RoboSAX/eagle_licht/soldering/connectors.jpg

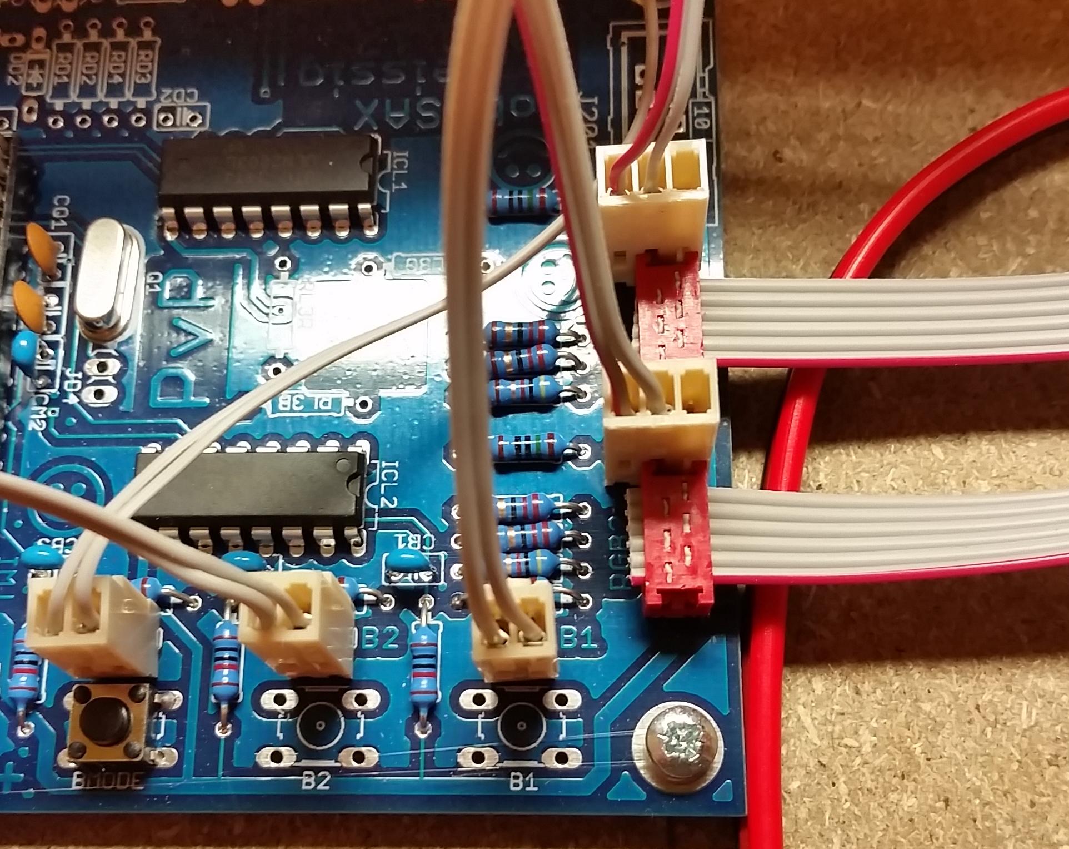
soldering/connectors.jpg
