RoboSAX/eagle_licht/soldering/rgb_led/rgb_led.jpg

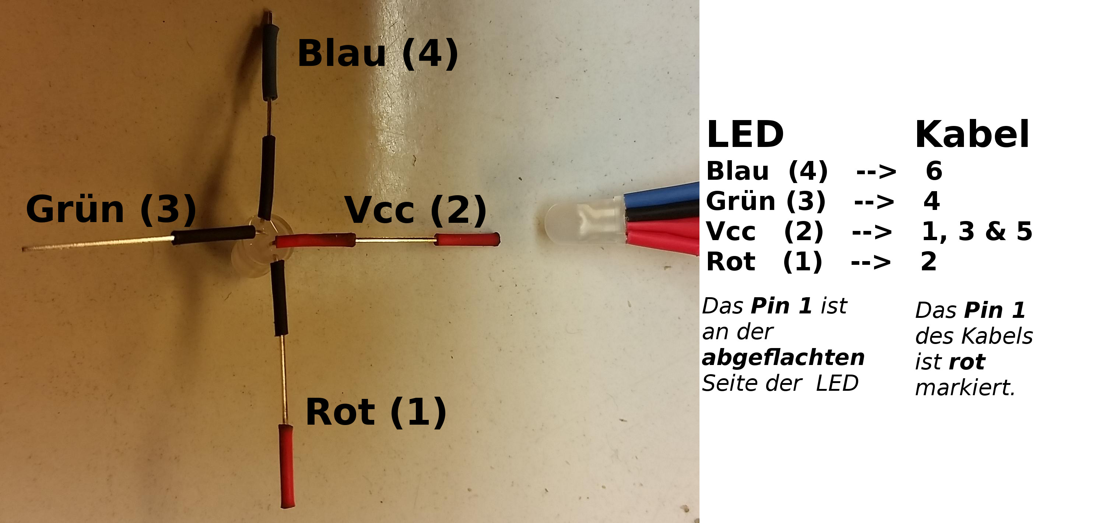
soldering/rgb_led/rgb_led.jpg
