RoboSAX/eagle_licht/README.md

# eagle_licht
Vereinfachte Platine für das Spielfeld des RoboSAX ab 2018
