RoboSAX/eagle_licht/export/images/simplified/circuit_simplified.png

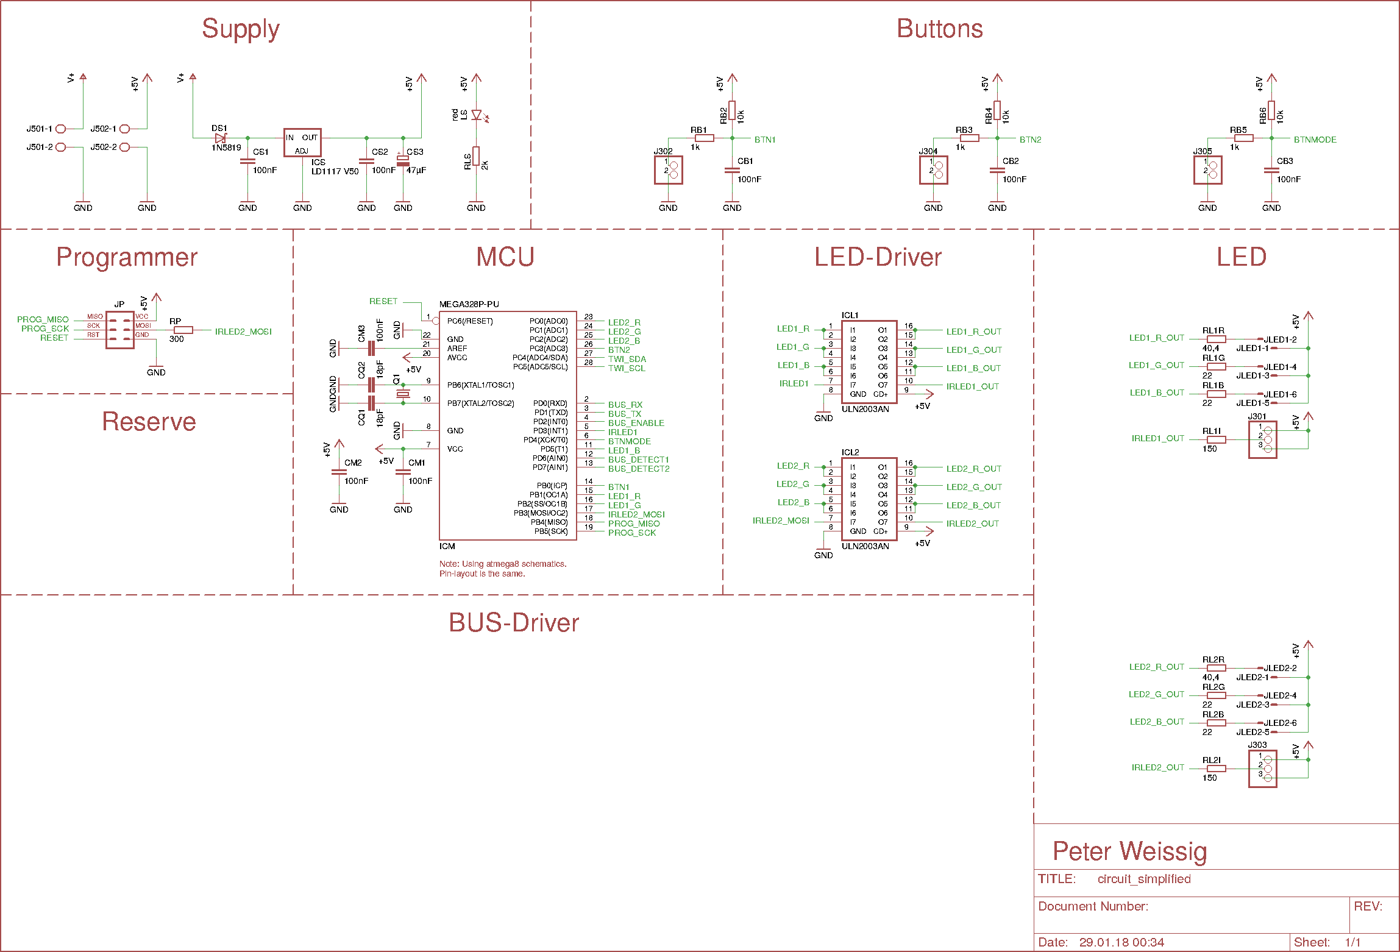
export/images/simplified/circuit_simplified.png
