RoboSAX/eagle_licht/parts/full/parts.pdf

## RoboSAX light tht

Peter Weissig | Seite 1 von 2 | 11.02.2018
Name | Value / Description | Order code | # | Prize | Sum
B1, B2, BMODE | button; 6x6mm; h=5mm | | 3 | 0,13 € | 0,39 €
CQ1, CQ2 | 18pF; 2,5mm | | 2 | 0,06 € | 0,12 €
CD1, CD2 | 100pF; 2,5mm | | 2 | 0,06 € | 0,12 €
| 100nF; 2,5mm | | 9 | 0,05 € | 0,45 €
CS3 | 47µF; 2mm; d=5mm | | 1 | 0,03 € | 0,03 €
DD1, DD2 | fast, low cap | | 2 | 0,02 € | 0,04 €
DS | low drop | | 1 | 0,06 € | 0,06 €
ICD | driver rs485 | | 1 | 0,34 € | 0,34 €
| | | 1 | 1,99 € | -
ICL1, ICL2 | transistor array | | 2 | 0,32 € | 0,64 €
ICM | atmega 328P | | 1 | 2,50 € | 2,50 €
ICS | low-drop; 5V; 1A | | 1 | 0,51 € | 0,51 €
JD1, JD2, JD3, JD4 | jumper; 1x2 pins | | 0,25 | 0,17 € | 0,04 €
| | | 4 | 0,04 € | -
J302, J304, J305 | special pin head; 1x2 pins (https://www.reichelt.de/Platinen-Steckverbinder/PSS-254-2G/3/index.html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) | 3 | 0,03 € | 0,09 €
J301, J303 | special pin head; 1x3 pins (https://www.reichelt.de/Platinen-Steckverbinder/PSS-254-3G/3/index.html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) | 2 | 0,03 € | 0,06 €
JP6 | special pin head; 90°; 1x6 | 1 | 0,14 € | 0,14 €
JT | female header; 1x4 pins | | 1 | 0,16 € | 0,16 €
| | | 0,25 | 0,27 € | -
JP | box header; 2x3 pins | | 1 | 0,16 € | 0,16 €
J201, J202 | box header; 2x5 pins | | 2 | 0,09 € | 0,18 €
JLED1, JLED2 | micromatch; 2x3 pins | | 2 | 0,31 € | 0,62 €
J501, J502 | connecting teminal; 2x | | 2 | 0,31 € | 0,62 €
LD2 | 3mm; 2mA; green | | 1 | 0,13 € | 0,13 €
LD1, LS | 3mm; 2mA, red | | 2 | 0,09 € | 0,18 €
LED3 | RGB-led; smd | | 1 | 0,40 € | 0,40 €
Q1 | crystal; 16 MHz | | 1 | 0,22 € | 0,22 €
RD3 | ? | ? | 1 | 0,05 € | 0,05 €
RD4 | ? | ? | 1 | 0,05 € | 0,05 €
| 22 | | 6 | 0,05 € | 0,30 €
RL1R, RL2R, RL3R | 40,4 | | 3 | 0,05 € | 0,15 €
| 150 | | 4 | 0,05 € | 0,20 €
RP | 300 | | 1 | 0,05 € | 0,05 €
| 1k | | 5 | 0,05 € | 0,25 €
RLD1, RLD2, RLS | 2k | | 3 | 0,05 € | 0,15 €
| 10k | | 5 | 0,05 € | 0,25 €
RD2 | 100k | | 1 | 0,05 € | 0,05 €

9,71 €

Shopping cart (most parts):

TASTER 9302 (https://www.reichelt.de/Kurzhubtaster/TASTER-9302/3/index.html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)
KERKO 18P (https://www.reichelt.de/Kurzhubtaster/TASTER-9302/3/index.html?ACTION=3;ARTICLE=9274)
KERKO 100P (https://www.reichelt.de/Kurzhubtaster/TASTER-9302/3/index.html?ACTION=3;ARTICLE=9266)
CB1, CB2, CB3
CM1, CM2, CM3,
CD3, CS1, CS2

X7R-2,5 100N (https://www.reichelt.de/Kurzhubtaster/TASTER-9302/3/index.html?ACTION=3;ARTICLE=22853)

RAD 105 47/35 (https://www.reichelt.de/Kurzhubtaster/TASTER-9302/3/index.html?ACTION=3;ARTICLE=42399)
1N 4151 DIO (https://www.reichelt.de/1N-UF-AA-Dioden/1N-4151-DIO/3/index.html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)
1N 5819 (https://www.reichelt.de/1N-UF-AA-Dioden/1N-4151-DIO/3/index.html?ACTION=3;ARTICLE=41850)
SN 75176BP (https://www.reichelt.de/1N-UF-AA-Dioden/1N-4151-DIO/3/index.html?ACTION=3;ARTICLE=19202)
ADM 485 JN (https://www.reichelt.de/1N-UF-AA-Dioden/1N-4151-DIO/3/index.html?ACTION=3;ARTICLE=107974)
ULN 2003A (https://www.reichelt.de/1N-UF-AA-Dioden/1N-4151-DIO/3/index.html?ACTION=3;ARTICLE=22069)
ATMEGA 328P-PU (https://www.reichelt.de/1N-UF-AA-Dioden/1N-4151-DIO/3/index.html?ACTION=3;ARTICLE=119685)
LD1117 V50 (https://www.reichelt.de/1N-UF-AA-Dioden/1N-4151-DIO/3/index.html?ACTION=3;ARTICLE=200893)
SL 1X36G 2,54 (https://www.reichelt.de/Stiftleisten/SL-1X36G-2-54/3/index.html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)
RND 205-00623 (https://www.reichelt.de/Stiftleisten/RND-205-00623/3/index.html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)
PSS 254/2G (https://www.reichelt.de/Platinen-Steckverbinder/PSS-254-2G/3/index.html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)
PSS 254/3G (https://www.reichelt.de/Platinen-Steckverbinder/PSS-254-3G/3/index.html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)
PSS 254/6W (https://www.reichelt.de/Platinen-Steckverbinder/PSS-254-2G/3/index.html?ACTION=3;ARTICLE=217631)
MPE 094-1-004 (https://www.reichelt.de/Buchsenleisten/MPE-094-1-004/3/index.html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)
BL 1X20G8 2,54 (https://www.reichelt.de/Buchsenleisten/MPE-094-1-004/3/index.html?ACTION=3;ARTICLE=51827)
WSL 6G (https://www.reichelt.de/Stiftleisten/RND-205-00623/3/index.html?ACTION=3;ARTICLE=85732)
WSL 10G (https://www.reichelt.de/Stiftleisten/RND-205-00623/3/index.html?ACTION=3;ARTICLE=22816)
MPE 369-1-006 (https://www.reichelt.de/Buchsenleisten/MPE-094-1-005/3/index.html?ACTION=3;ARTICLE=120008)
AKL 101-02 (https://www.reichelt.de/Buchsenleisten/MPE-094-1-005/3/index.html?ACTION=3;ARTICLE=36605)
LED 3MM 2MA GN (https://www.reichelt.de/Platinen-Steckverbinder/PSK-254-2W/3/index.html?ACTION=3;ARTICLE=21624)
LED 3MM 2MA RT (https://www.reichelt.de/Platinen-Steckverbinder/PSK-254-2W/3/index.html?ACTION=3;ARTICLE=21626)
LRTBG6TG (other) (https://www.ebay.de/itm/LRTBG6TG-RGB-PLCC6-6-LEAD-MULTILED-rot-grun-blau-LED-OSRAM-100-Stuck-/191014679655)
16,0000-HC49U-S (https://www.reichelt.de/Platinen-Steckverbinder/PSK-254-2W/3/index.html?ACTION=3;ARTICLE=32852)

RL1B, RL1G, RL2B,
RL2G, RL3B, RL3G

METALL 22,0 (https://www.reichelt.de/Platinen-Steckverbinder/PSK-254-2W/3/index.html?ACTION=3;ARTICLE=11621)

METALL 40,2 (https://www.reichelt.de/Platinen-Steckverbinder/PSK-254-2W/3/index.html?ACTION=3;ARTICLE=11790)
RL1I, RL2I, RD1,
RD6

METALL 150 (https://www.reichelt.de/Platinen-Steckverbinder/PSK-254-2W/3/index.html?ACTION=3;ARTICLE=11527)

METALL 300 (https://www.reichelt.de/Platinen-Steckverbinder/PSK-254-2W/3/index.html?ACTION=3;ARTICLE=11715)
RB1, RB3, RB5,
RD5, RD7

METALL 1,00K (https://www.reichelt.de/Platinen-Steckverbinder/PSK-254-2W/3/index.html?ACTION=3;ARTICLE=11403)

METALL 2,00K (https://www.reichelt.de/Platinen-Steckverbinder/PSK-254-2W/3/index.html?ACTION=3;ARTICLE=11578)
RB2, RB4, RB6,
RD8, RD9

METALL 10,0K (https://www.reichelt.de/Platinen-Steckverbinder/PSK-254-2W/3/index.html?ACTION=3;ARTICLE=11449)

METALL 100K (https://www.reichelt.de/Platinen-Steckverbinder/PSK-254-2W/3/index.html?ACTION=3;ARTICLE=11458)

https://www.reichelt.de/my/1433464

## Additionals

Peter Weissig | Seite 2 von 2 | 11.02.2018
Related Part | Value / Description | Order code | # | Prize | Sum
ICD | ic socket; 2x4 | 1 | 0,04 € | 0,04 €
ICL1, ICL2 | ic socket; 2x8 | 2 | 0,05 € | 0,10 €
ICM | ic socket; 2x14 | 1 | 0,10 € | 0,10 €
J302, J304, J305 | special socket; 1x2 pins | 3 | 0,01 € | 0,03 €
J301, J303 | special socket; 1x3 pins | 2 | 0,01 € | 0,02 €
JP6 | special socket; 1x6 pins | 1 | 0,07 € | 0,07 €
pins for special connector | 0,29 € | 0,29 €
JLED1, JLED2 | micromatch; 2x3 pins | 2 | 0,24 € | 0,48 €
J201, J202 | connector for box header | 2 | 0,09 € | 0,18 €
J501 | wire; 2x0,75mm²; power | | | 10,30 € | 0,21 €
| wire; 10x0,1mm²; data | | | 8,60 € | 0,29 €
| shrink tubing; d=1,6mm; b (https://www.reichelt.de/Schrumpfschlauch-Abschnitte/SDH-1-6-SW/3/index.html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) | | 0,25 € | 0,03 €
| shrink tubing; d=1,6mm; r | | 0,32 € | 0,03 €
JLED1, JLED2, JT | shrink tubing; d=1,6mm; b (https://www.reichelt.de/Schrumpfschlauch-Abschnitte/SDH-1-6-SW/3/index.html?ACTION=3;ARTICLE=17392) | | 0,32 € | 0,03 €
J302, J304, J305 | shrink tubing; d=3,2mm; b (https://www.reichelt.de/?ACTION=3;ARTICLE=17406) | | 0,26 € | 0,03 €
JLED1, JLED2 | shrink tubing; d=3,2mm; r | | 0,31 € | 0,03 €
J501 | shrink tubing; d=6,4mm; r | | 0,50 € | 0,05 €
J501 | switch; power supply | 1 | 0,81 € | 0,81 €
B1, B2, BMODE | button; signal | 3 | 0,47 € | 1,41 €
J501 | battery; 9V | 1 | 0,99 € | 0,99 €
J501 | battery clip | 1 | 0,67 € | 0,67 €
J301, J303 | IR led; 5mm | 2 | 0,26 € | 0,52 €
JLED1, JLED2 | RGB led; 5-8mm | | 7,99 € | 0,16 €
ICS | screw; m3; 8mm | | 1,99 € | 0,01 €
ICS | nut; m3 | | 2,50 € | 0,03 €
| washer; m3 | | 1,85 € | 0,11 €
| screw; 2,9mm | | 1,75 € | 0,11 €

6,77 €

Shopping cart (most parts):

GS 8 (https://www.reichelt.de/?ACTION=3;ARTICLE=8230)
GS 16 (https://www.reichelt.de/?ACTION=3;ARTICLE=8208)
GS 28-S (https://www.reichelt.de/?ACTION=3;ARTICLE=86281)
PSK 254/2W (https://www.reichelt.de/Platinen-Steckverbinder/PSK-KONTAKTE/3/index.html?ACTION=3;ARTICLE=14857)
PSK 254/3W (https://www.reichelt.de/Platinen-Steckverbinder/PSK-254-3W/3/index.html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)
PSK 254/6W (https://www.reichelt.de/Platinen-Steckverbinder/PSK-KONTAKTE/3/index.html?ACTION=3;ARTICLE=147625)
J301, J302, J303, J304,
J305, JP6
PSK-KONTAKTE (https://www.reichelt.de/Platinen-Steckverbinder/PSK-KONTAKTE/3/index.html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) | 18 (20)

MPE 372-1-006 (https://www.reichelt.de/Platinen-Steckverbinder/PSK-254-3W/3/index.html?ACTION=3;ARTICLE=120050)
PFL 10 (https://www.reichelt.de/Pfosten-Wannenstecker/2/index.html?ACTION=3;ARTICLE=14571)
LA 275-50 (https://www.reichelt.de/Pfosten-Wannenstecker/2/index.html?ACTION=3;ARTICLE=36246) | 1 (50)

J201, J202,
JLED1, JLED2, JT,
J301, J303,
J302, J304, J305

AWG 28-10G 30M (https://www.reichelt.de/Flachbandkabel/AWG-28-10G-30M/3/index.html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) 1 (30)

JLED1, JLED2,
J301, J303
SDH 1,6 SW (https://www.reichelt.de/Schrumpfschlauch-Abschnitte/SDH-1-6-SW/3/index.html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) | 1 (10)

JLED1, JLED2,
J301, J303
SDH 1,6 RT (https://www.reichelt.de/Schrumpfschlauch-Abschnitte/SDH-1-6-SW/3/index.html?ACTION=3;ARTICLE=17393) | 1 (10)
SDH 1,6 BL (https://www.reichelt.de/Schrumpfschlauch-Abschnitte/SDH-1-6-SW/3/index.html?ACTION=3;ARTICLE=17392) | 1 (10)
SDH 3,2 SW (https://www.reichelt.de/?ACTION=3;ARTICLE=17406) | 1 (10)
SDH 3,2 RT (https://www.reichelt.de/?ACTION=3;ARTICLE=17405) | 1 (10)
SDH 6,4 RT (https://www.reichelt.de/?ACTION=3;ARTICLE=17413) | 1 (10)

WS R13-112 AAAA (https://www.reichelt.de/Wippschalter/WS-R13-112-AAAA/3/index.html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)
T 113A RT (https://www.reichelt.de/Drucktaster-Druckschalter/T-113A-RT/3/index.html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)
VAR IND1 9V (https://www.reichelt.de/Alkalinebatterien/VAR-IND1-9V/3/index.html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)
HALTER 9V (https://www.reichelt.de/Batteriehalter-fuer-9V-Block/HALTER-9V/3/index.html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)
CQY 99 (https://www.reichelt.de/Fotodioden-etc-/CQY-99/3/index.html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)
Amazon (https://www.amazon.de/St%C3%BCck-Ultra-Helle-Indirekt-Common/dp/B00H96MFNI/ref=sr_1_1) | 2 (100)
SZK M3X8-200 (https://www.reichelt.de/Flachbandkabel/AWG-28-10G-30M/3/index.html?ACTION=3;ARTICLE=65693) | 1 (200)
SK-E M3-100 (https://www.reichelt.de/Flachbandkabel/AWG-28-10G-30M/3/index.html?ACTION=3;ARTICLE=72592) | 1 (100)

ICS,
corners of circuit board
SKU-E 3,2-100 (https://www.reichelt.de/Flachbandkabel/AWG-28-10G-30M/3/index.html?ACTION=3;ARTICLE=72588) | 6 (100)

corners of circuit board,
battery clip
SBL 2916-100 (https://www.reichelt.de/Blechschrauben/SBL-2913-100/3/index.html?ACTION=3;ARTICLE=130327) | 6 (100)

https://www.reichelt.de/my/1433464
