RoboSAX/eagle_licht/parts/full/parts.ods

Sheet: RoboSAX light tht
Name | Value / Description | Order code | # | Prize | Sum
B1, B2, BMODE | button; 6x6mm; h=5mm | TASTER 9302 (https://www.reichelt.de/Kurzhubtaster/TASTER-9302/3/index.html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) | 3 | 0,13 € | 0,39 €
CQ1, CQ2 | 18pF; 2,5mm | KERKO 18P (https://www.reichelt.de/Kurzhubtaster/TASTER-9302/3/index.html?ACTION=3;ARTICLE=9274) | 2 | 0,06 € | 0,12 €
CD1, CD2 | 100pF; 2,5mm | KERKO 100P (https://www.reichelt.de/Kurzhubtaster/TASTER-9302/3/index.html?ACTION=3;ARTICLE=9266) | 2 | 0,06 € | 0,12 €
CB1, CB2, CB3 CM1, CM2, CM3, CD3, CS1, CS2 | 100nF; 2,5mm | X7R-2,5 100N (https://www.reichelt.de/Kurzhubtaster/TASTER-9302/3/index.html?ACTION=3;ARTICLE=22853) | 9 | 0,05 € | 0,45 €
CS3 | 47µF; 2mm; d=5mm | RAD 105 47/35 (https://www.reichelt.de/Kurzhubtaster/TASTER-9302/3/index.html?ACTION=3;ARTICLE=42399) | 1 | 0,03 € | 0,03 €
DD1, DD2 | fast, low cap | 1N 4151 DIO (https://www.reichelt.de/1N-UF-AA-Dioden/1N-4151-DIO/3/index.html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) | 2 | 0,02 € | 0,04 €
DS | low drop | 1N 5819 (https://www.reichelt.de/1N-UF-AA-Dioden/1N-4151-DIO/3/index.html?ACTION=3;ARTICLE=41850) | 1 | 0,06 € | 0,06 €
ICD | driver rs485 | SN 75176BP (https://www.reichelt.de/1N-UF-AA-Dioden/1N-4151-DIO/3/index.html?ACTION=3;ARTICLE=19202) | 1 | 0,34 € | 0,34 €
 |  | ADM 485 JN (https://www.reichelt.de/1N-UF-AA-Dioden/1N-4151-DIO/3/index.html?ACTION=3;ARTICLE=107974) | 1 | 1,99 € | -
ICL1, ICL2 | transistor array | ULN 2003A (https://www.reichelt.de/1N-UF-AA-Dioden/1N-4151-DIO/3/index.html?ACTION=3;ARTICLE=22069) | 2 | 0,32 € | 0,64 €
ICM | atmega 328P | ATMEGA 328P-PU (https://www.reichelt.de/1N-UF-AA-Dioden/1N-4151-DIO/3/index.html?ACTION=3;ARTICLE=119685) | 1 | 2,50 € | 2,50 €
ICS | low-drop; 5V; 1A | LD1117 V50 (https://www.reichelt.de/1N-UF-AA-Dioden/1N-4151-DIO/3/index.html?ACTION=3;ARTICLE=200893) | 1 | 0,51 € | 0,51 €
JD1, JD2, JD3, JD4 | jumper; 1x2 pins | SL 1X36G 2,54 (https://www.reichelt.de/Stiftleisten/SL-1X36G-2-54/3/index.html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) | 0,25 | 0,17 € | 0,04 €
 |  | RND 205-00623 (https://www.reichelt.de/Stiftleisten/RND-205-00623/3/index.html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) | 4 | 0,04 € | -
J302, J304, J305 | special pin head; 1x2 pins | PSS 254/2G (https://www.reichelt.de/Platinen-Steckverbinder/PSS-254-2G/3/index.html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) | 3 | 0,03 € | 0,09 €
J301, J303 | special pin head; 1x3 pins | PSS 254/3G (https://www.reichelt.de/Platinen-Steckverbinder/PSS-254-3G/3/index.html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) | 2 | 0,03 € | 0,06 €
JP6 | special pin head; 90°; 1x6 pins | PSS 254/6W (https://www.reichelt.de/Platinen-Steckverbinder/PSS-254-2G/3/index.html?ACTION=3;ARTICLE=217631) | 1 | 0,14 € | 0,14 €
JT | female header; 1x4 pins | MPE 094-1-004 (https://www.reichelt.de/Buchsenleisten/MPE-094-1-004/3/index.html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) | 1 | 0,16 € | 0,16 €
 |  | BL 1X20G8 2,54 (https://www.reichelt.de/Buchsenleisten/MPE-094-1-004/3/index.html?ACTION=3;ARTICLE=51827) | 0,25 | 0,27 € | -
JP | box header; 2x3 pins | WSL 6G (https://www.reichelt.de/Stiftleisten/RND-205-00623/3/index.html?ACTION=3;ARTICLE=85732) | 1 | 0,16 € | 0,16 €
J201, J202 | box header; 2x5 pins | WSL 10G (https://www.reichelt.de/Stiftleisten/RND-205-00623/3/index.html?ACTION=3;ARTICLE=22816) | 2 | 0,09 € | 0,18 €
JLED1, JLED2 | micromatch; 2x3 pins | MPE 369-1-006 (https://www.reichelt.de/Buchsenleisten/MPE-094-1-005/3/index.html?ACTION=3;ARTICLE=120008) | 2 | 0,31 € | 0,62 €
J501, J502 | connecting teminal; 2x | AKL 101-02 (https://www.reichelt.de/Buchsenleisten/MPE-094-1-005/3/index.html?ACTION=3;ARTICLE=36605) | 2 | 0,31 € | 0,62 €
LD2 | 3mm; 2mA; green | LED 3MM 2MA GN (https://www.reichelt.de/Platinen-Steckverbinder/PSK-254-2W/3/index.html?ACTION=3;ARTICLE=21624) | 1 | 0,13 € | 0,13 €
LD1, LS | 3mm; 2mA, red | LED 3MM 2MA RT (https://www.reichelt.de/Platinen-Steckverbinder/PSK-254-2W/3/index.html?ACTION=3;ARTICLE=21626) | 2 | 0,09 € | 0,18 €
LED3 | RGB-led; smd | LRTBG6TG (other) (https://www.ebay.de/itm/LRTBG6TG-RGB-PLCC6-6-LEAD-MULTILED-rot-grun-blau-LED-OSRAM-100-Stuck-/191014679655) | 1 | 0,40 € | 0,40 €
Q1 | crystal; 16 MHz | 16,0000-HC49U-S (https://www.reichelt.de/Platinen-Steckverbinder/PSK-254-2W/3/index.html?ACTION=3;ARTICLE=32852) | 1 | 0,22 € | 0,22 €
RD3 | ? | ? | 1 | 0,05 € | 0,05 €
RD4 | ? | ? | 1 | 0,05 € | 0,05 €
RL1B, RL1G, RL2B, RL2G, RL3B, RL3G | 22 | METALL 22,0 (https://www.reichelt.de/Platinen-Steckverbinder/PSK-254-2W/3/index.html?ACTION=3;ARTICLE=11621) | 6 | 0,05 € | 0,30 €
RL1R, RL2R, RL3R | 40,4 | METALL 40,2 (https://www.reichelt.de/Platinen-Steckverbinder/PSK-254-2W/3/index.html?ACTION=3;ARTICLE=11790) | 3 | 0,05 € | 0,15 €
RL1I, RL2I, RD1, RD6 | 150 | METALL 150 (https://www.reichelt.de/Platinen-Steckverbinder/PSK-254-2W/3/index.html?ACTION=3;ARTICLE=11527) | 4 | 0,05 € | 0,20 €
RP | 300 | METALL 300 (https://www.reichelt.de/Platinen-Steckverbinder/PSK-254-2W/3/index.html?ACTION=3;ARTICLE=11715) | 1 | 0,05 € | 0,05 €
RB1, RB3, RB5, RD5, RD7 | 1k | METALL 1,00K (https://www.reichelt.de/Platinen-Steckverbinder/PSK-254-2W/3/index.html?ACTION=3;ARTICLE=11403) | 5 | 0,05 € | 0,25 €
RLD1, RLD2, RLS | 2k | METALL 2,00K (https://www.reichelt.de/Platinen-Steckverbinder/PSK-254-2W/3/index.html?ACTION=3;ARTICLE=11578) | 3 | 0,05 € | 0,15 €
RB2, RB4, RB6, RD8, RD9 | 10k | METALL 10,0K (https://www.reichelt.de/Platinen-Steckverbinder/PSK-254-2W/3/index.html?ACTION=3;ARTICLE=11449) | 5 | 0,05 € | 0,25 €
RD2 | 100k | METALL 100K (https://www.reichelt.de/Platinen-Steckverbinder/PSK-254-2W/3/index.html?ACTION=3;ARTICLE=11458) | 1 | 0,05 € | 0,05 €
 |  |  | 9,71 €
Shopping cart (most parts): |  | https://www.reichelt.de/my/1433464

Sheet: Additionals
Related Part | Value / Description | Order code | # | Prize | Sum
ICD | ic socket; 2x4 | GS 8 (https://www.reichelt.de/?ACTION=3;ARTICLE=8230) | 1 | 0,04 € | 0,04 €
ICL1, ICL2 | ic socket; 2x8 | GS 16 (https://www.reichelt.de/?ACTION=3;ARTICLE=8208) | 2 | 0,05 € | 0,10 €
ICM | ic socket; 2x14 | GS 28-S (https://www.reichelt.de/?ACTION=3;ARTICLE=86281) | 1 | 0,10 € | 0,10 €
J302, J304, J305 | special socket; 1x2 pins | PSK 254/2W (https://www.reichelt.de/Platinen-Steckverbinder/PSK-KONTAKTE/3/index.html?ACTION=3;ARTICLE=14857) | 3 | 0,01 € | 0,03 €
J301, J303 | special socket; 1x3 pins | PSK 254/3W (https://www.reichelt.de/Platinen-Steckverbinder/PSK-254-3W/3/index.html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) | 2 | 0,01 € | 0,02 €
JP6 | special socket; 1x6 pins | PSK 254/6W (https://www.reichelt.de/Platinen-Steckverbinder/PSK-KONTAKTE/3/index.html?ACTION=3;ARTICLE=147625) | 1 | 0,07 € | 0,07 €
J301, J302, J303, J304, J305, JP6 | pins for special connector | PSK-KONTAKTE (https://www.reichelt.de/Platinen-Steckverbinder/PSK-KONTAKTE/3/index.html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) | 18 (20) | 0,29 € | 0,29 €
JLED1, JLED2 | micromatch; 2x3 pins | MPE 372-1-006 (https://www.reichelt.de/Platinen-Steckverbinder/PSK-254-3W/3/index.html?ACTION=3;ARTICLE=120050) | 2 | 0,24 € | 0,48 €
J201, J202 | connector for box header | PFL 10 (https://www.reichelt.de/Pfosten-Wannenstecker/2/index.html?ACTION=3;ARTICLE=14571) | 2 | 0,09 € | 0,18 €
J501 | wire; 2x0,75mm²; power | LA 275-50 (https://www.reichelt.de/Pfosten-Wannenstecker/2/index.html?ACTION=3;ARTICLE=36246) | 1 (50) | 10,30 € | 0,21 €
J201, J202, JLED1, JLED2, JT, J301, J303, J302, J304, J305 | wire; 10x0,1mm²; data | AWG 28-10G 30M (https://www.reichelt.de/Flachbandkabel/AWG-28-10G-30M/3/index.html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) | 1 (30) | 8,60 € | 0,29 €
JLED1, JLED2, J301, J303 | shrink tubing; d=1,6mm; black | SDH 1,6 SW (https://www.reichelt.de/Schrumpfschlauch-Abschnitte/SDH-1-6-SW/3/index.html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) | 1 (10) | 0,25 € | 0,03 €
JLED1, JLED2, J301, J303 | shrink tubing; d=1,6mm; red | SDH 1,6 RT (https://www.reichelt.de/Schrumpfschlauch-Abschnitte/SDH-1-6-SW/3/index.html?ACTION=3;ARTICLE=17393) | 1 (10) | 0,32 € | 0,03 €
JLED1, JLED2, JT | shrink tubing; d=1,6mm; blue | SDH 1,6 BL (https://www.reichelt.de/Schrumpfschlauch-Abschnitte/SDH-1-6-SW/3/index.html?ACTION=3;ARTICLE=17392) | 1 (10) | 0,32 € | 0,03 €
J302, J304, J305 | shrink tubing; d=3,2mm; black | SDH 3,2 SW (https://www.reichelt.de/?ACTION=3;ARTICLE=17406) | 1 (10) | 0,26 € | 0,03 €
JLED1, JLED2 | shrink tubing; d=3,2mm; red | SDH 3,2 RT (https://www.reichelt.de/?ACTION=3;ARTICLE=17405) | 1 (10) | 0,31 € | 0,03 €
J501 | shrink tubing; d=6,4mm; red | SDH 6,4 RT (https://www.reichelt.de/?ACTION=3;ARTICLE=17413) | 1 (10) | 0,50 € | 0,05 €
J501 | switch; power supply | WS R13-112 AAAA (https://www.reichelt.de/Wippschalter/WS-R13-112-AAAA/3/index.html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) | 1 | 0,81 € | 0,81 €
B1, B2, BMODE | button; signal | T 113A RT (https://www.reichelt.de/Drucktaster-Druckschalter/T-113A-RT/3/index.html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) | 3 | 0,47 € | 1,41 €
J501 | battery; 9V | VAR IND1 9V (https://www.reichelt.de/Alkalinebatterien/VAR-IND1-9V/3/index.html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) | 1 | 0,99 € | 0,99 €
J501 | battery clip | HALTER 9V (https://www.reichelt.de/Batteriehalter-fuer-9V-Block/HALTER-9V/3/index.html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) | 1 | 0,67 € | 0,67 €
J301, J303 | IR led; 5mm | CQY 99 (https://www.reichelt.de/Fotodioden-etc-/CQY-99/3/index.html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) | 2 | 0,26 € | 0,52 €
JLED1, JLED2 | RGB led; 5-8mm | Amazon (https://www.amazon.de/Stück-Ultra-Helle-Indirekt-Common/dp/B00H96MFNI/ref=sr_1_1) | 2 (100) | 7,99 € | 0,16 €
ICS | screw; m3; 8mm | SZK M3X8-200 (https://www.reichelt.de/Flachbandkabel/AWG-28-10G-30M/3/index.html?ACTION=3;ARTICLE=65693) | 1 (200) | 1,99 € | 0,01 €
ICS | nut; m3 | SK-E M3-100 (https://www.reichelt.de/Flachbandkabel/AWG-28-10G-30M/3/index.html?ACTION=3;ARTICLE=72592) | 1 (100) | 2,50 € | 0,03 €
ICS, corners of circuit board | washer; m3 | SKU-E 3,2-100 (https://www.reichelt.de/Flachbandkabel/AWG-28-10G-30M/3/index.html?ACTION=3;ARTICLE=72588) | 6 (100) | 1,85 € | 0,11 €
corners of circuit board, battery clip | screw; 2,9mm | SBL 2916-100 (https://www.reichelt.de/Blechschrauben/SBL-2913-100/3/index.html?ACTION=3;ARTICLE=130327) | 6 (100) | 1,75 € | 0,11 €
 |  |  | 6,77 €
Shopping cart (most parts): |  | https://www.reichelt.de/my/1433464
