RoboSAX/eagle_licht/export/images/simplified/parts_bottom_simplified__empty.png

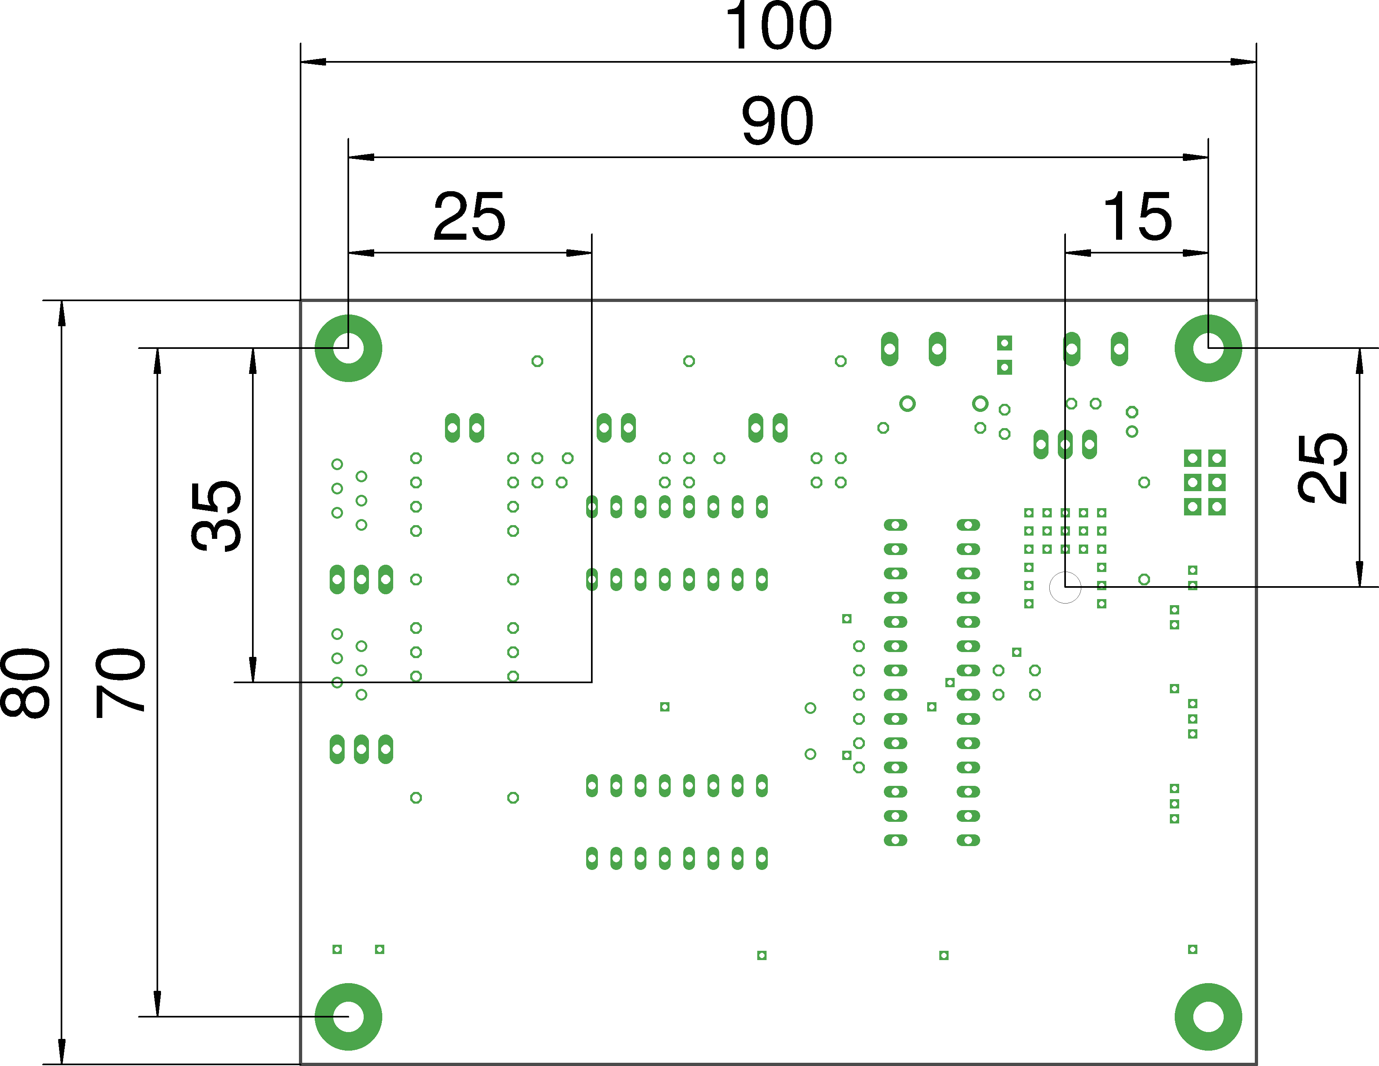
export/images/simplified/parts_bottom_simplified__empty.png
