RoboSAX/eagle_licht/export/images/simplified/parts_top_simplified.png

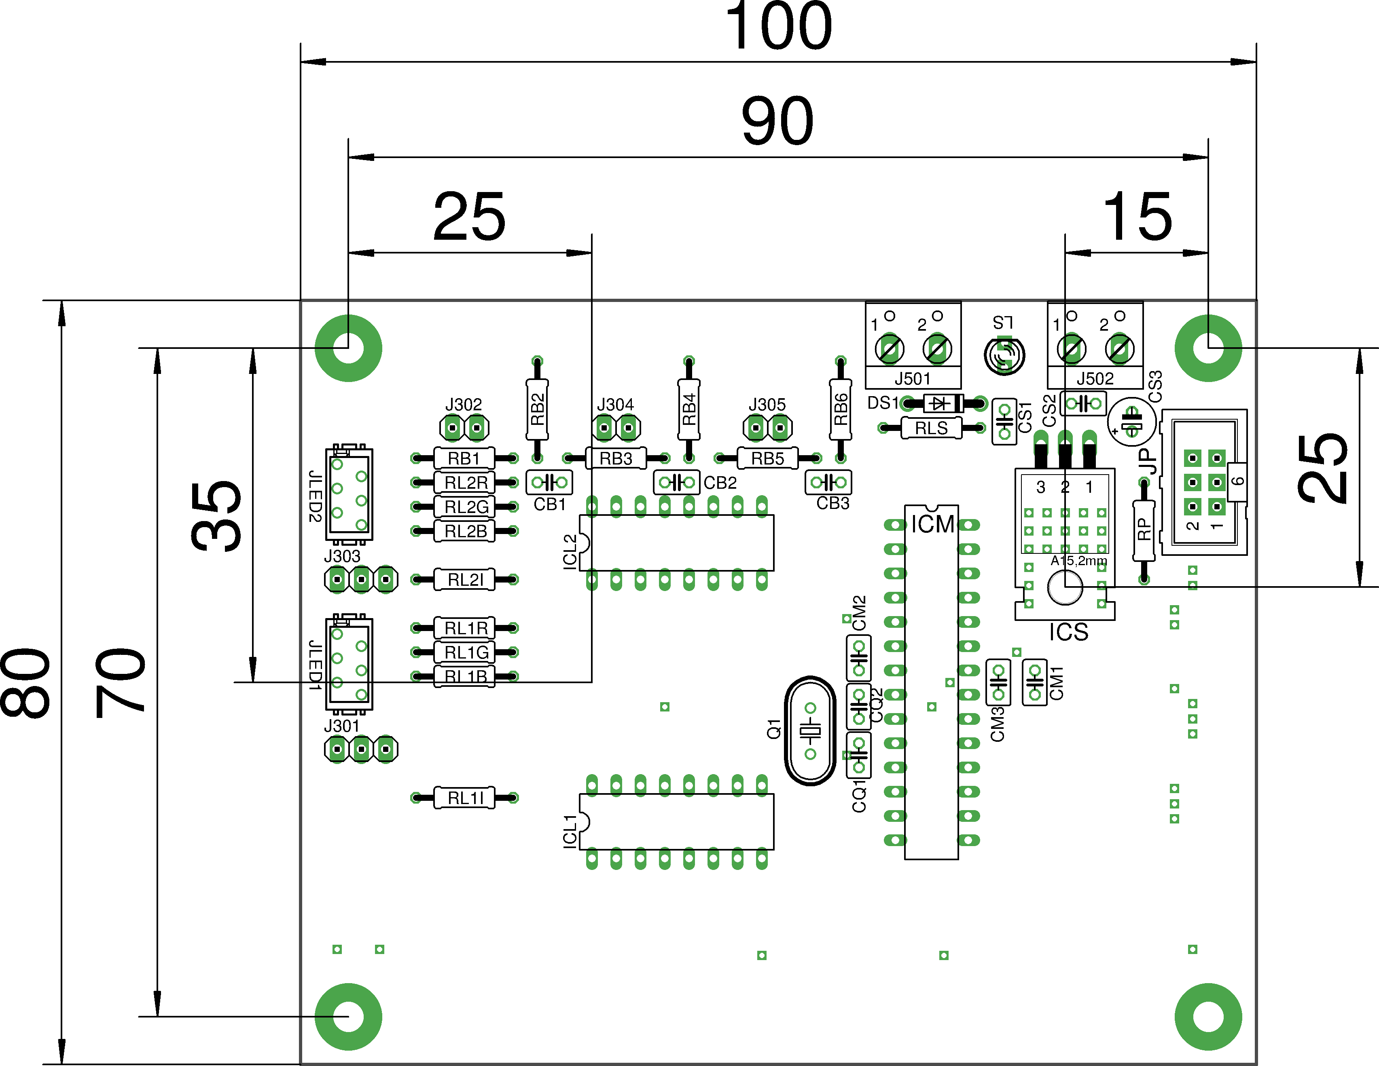
export/images/simplified/parts_top_simplified.png
