RoboSAX/eagle_licht/soldering/rgb_led/rgb_led.odt

RGB-LED


Anschlüsse
