RoboSAX/eagle_licht/export/images/full/circuit.pdf

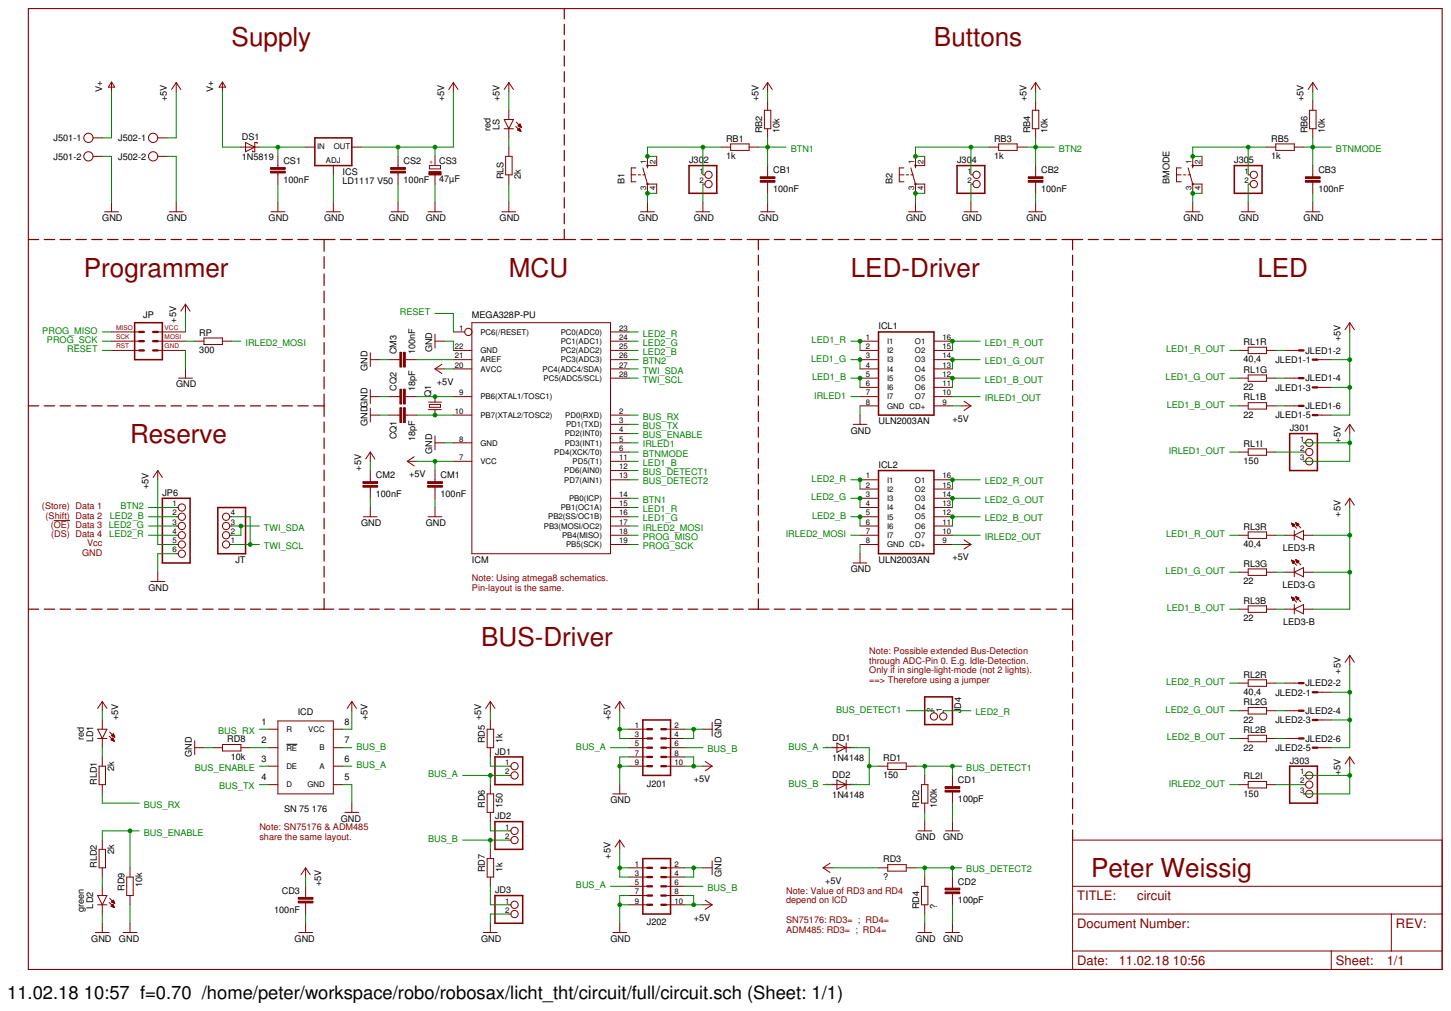
[picture p6: page 1]

ICM
Note: Using atmega8 schematics. Pin-layout is the same.
BUS-Driver

Note: Possible extended Bus-Detection
through ADC-Pin 0. E.g. Idle-Detection. Only if in single-light-mode (not 2 lights). ==> Therefore using a jumper

REV: TITLE: Document Number: circuit

11.02.18 10:57 f=0.70 /home/peter/workspace/robo/robosax/licht_tht/circuit/full/circuit.sch (Sheet: 1/1)
