RoboSAX/eagle_licht/export/images/simplified/circuit_simplified.pdf

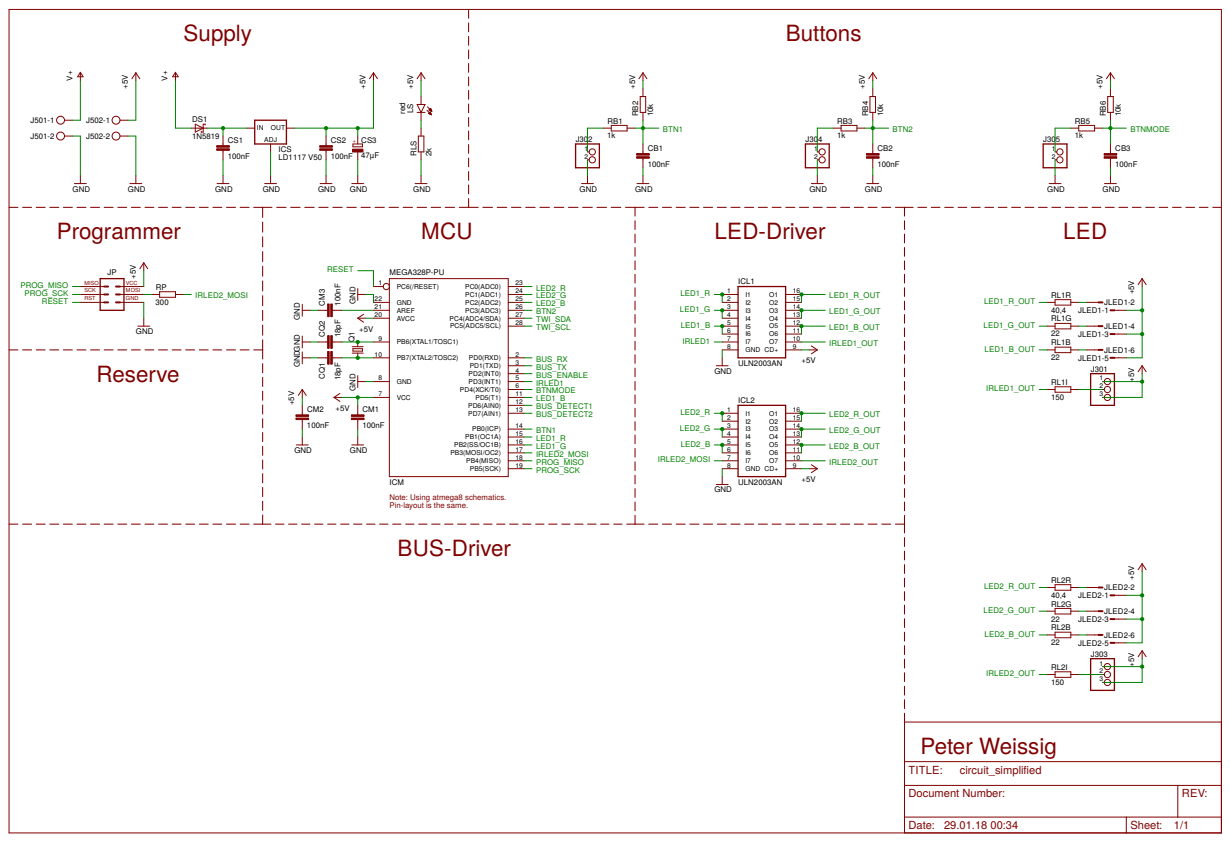
[picture p7: page 1]

ICM
Note: Using atmega8 schematics. Pin-layout is the same.
BUS-Driver

REV: TITLE: Document Number: circuit_simplified

Date: 29.01.18 00:34 | Sheet: 1/1
