RoboSAX/eagle_licht/circuit/full/circuit.brd

## EAGLE design circuit/full/circuit.brd (2018-02-11)

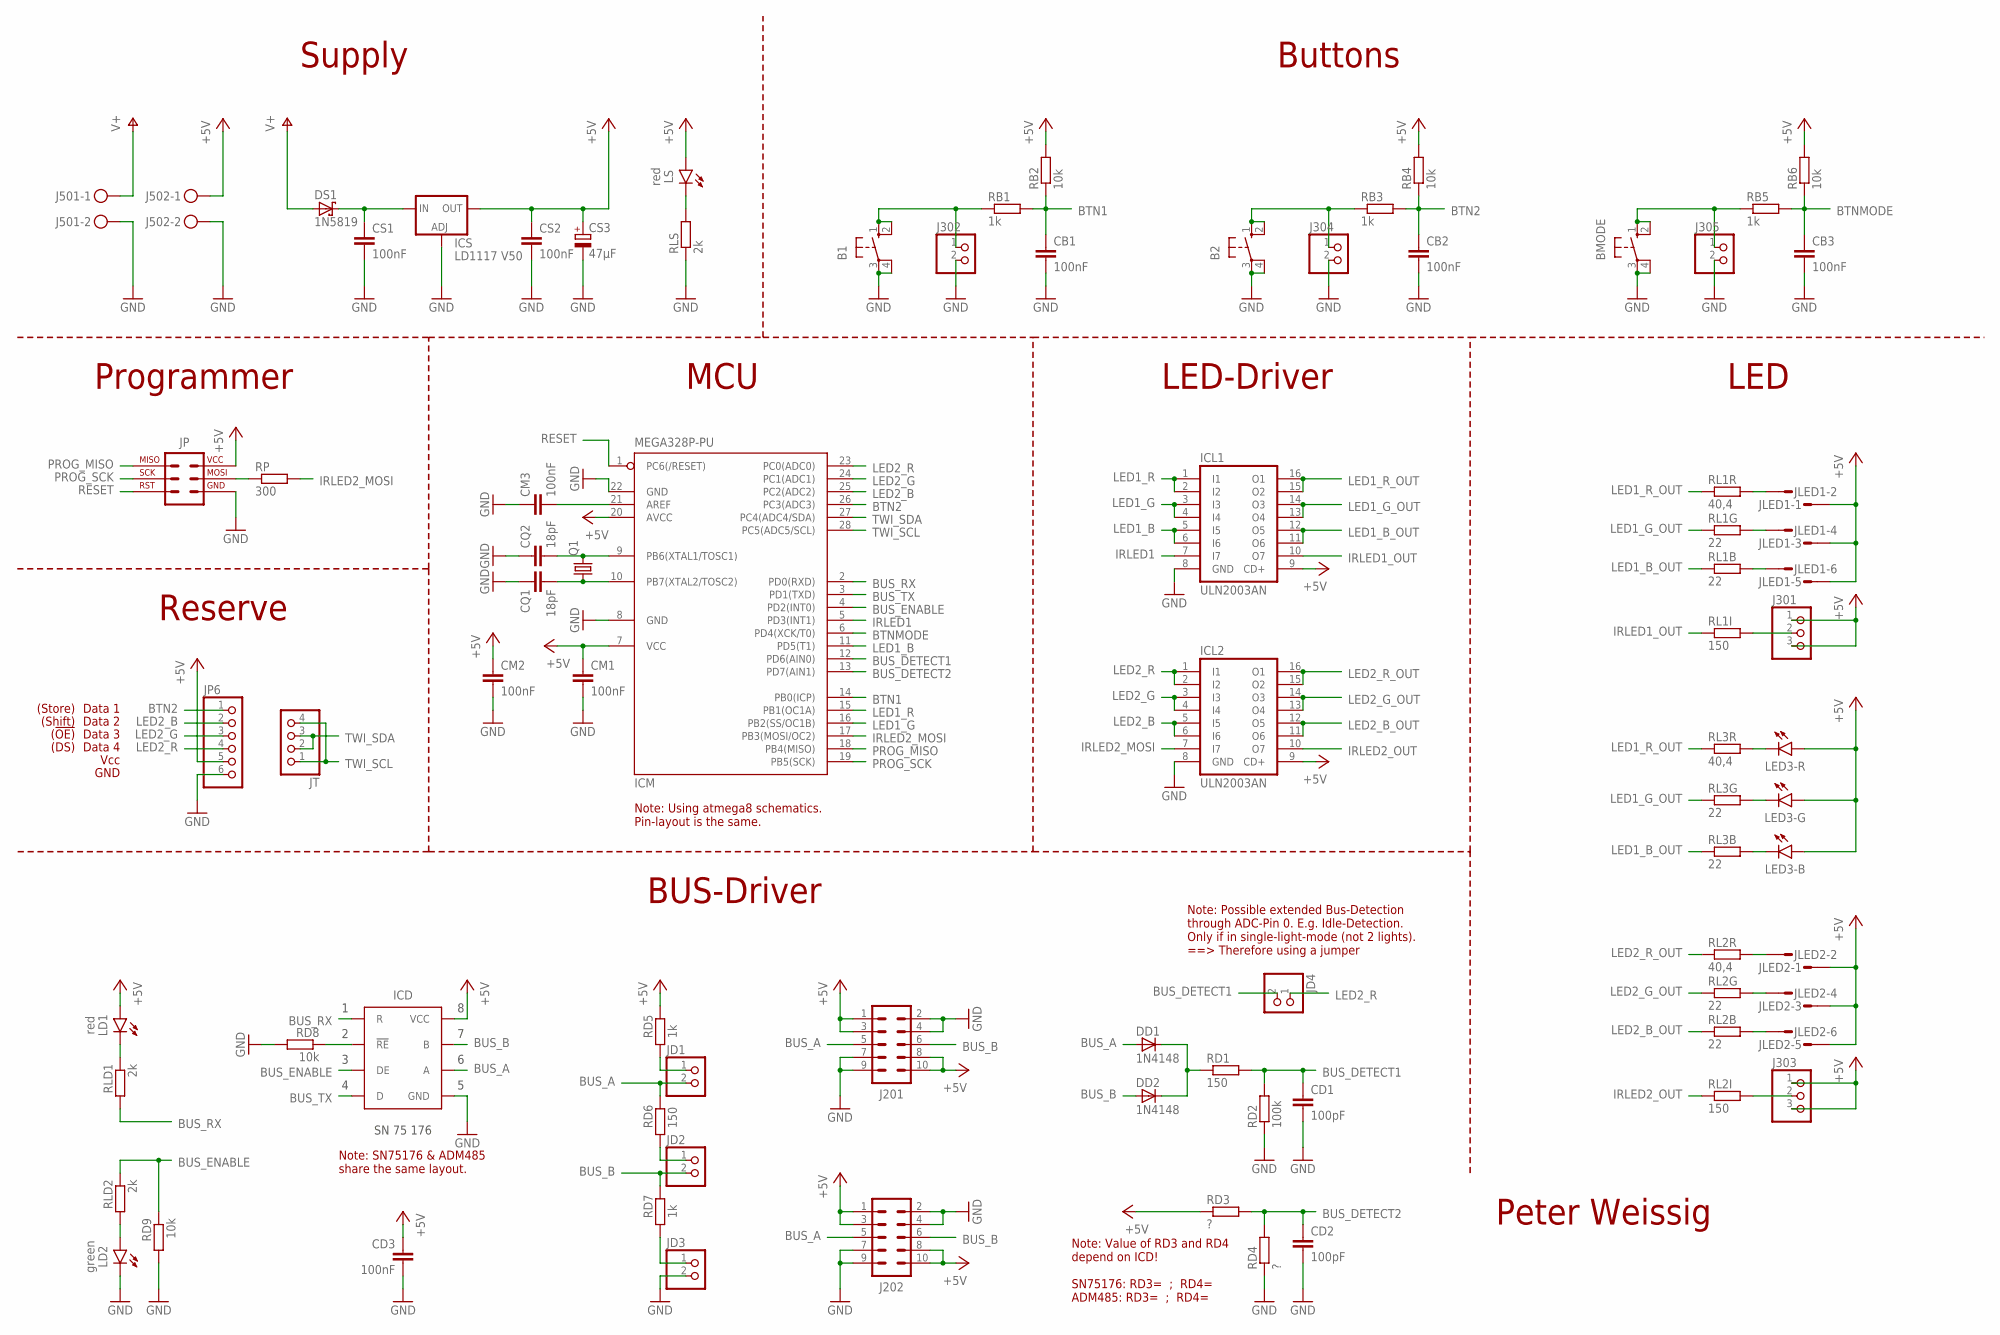
[picture p8: schematic circuit.sch]

Parts:
B1, B2: 10-XX; B3F-10XX
BMODE: 10-XX; B3F-10XX
CB1, CB2, CB3: 100nF; C025-025X050
CD1, CD2: 100pF; C025-025X050
CD3: 100nF; C025-025X050
CM1, CM2, CM3: 100nF; C025-025X050
CQ1, CQ2: 18pF; C025-025X050
CS1, CS2: 100nF; C025-025X050
CS3: 47µF; E2-5
DD1, DD2: 1N4148; DO35-7
DS1: 1N5819; DO41-7.6
ICD: DRIVER_RS485; IC_DIL08
ICL1, ICL2: ULN2003AN; DIL16
ICM: MEGA328P-PU; DIL28-3
ICS: LD1117 V50; TO220L1
J201, J202: STECKER_WANNE_10
J301, J303: PINHD-1X3; 1X03
J302, J304, J305: PINHD-1X2; 1X02
J501, J502: STECKER_SPG_2
JD1, JD2, JD3, JD4: PINHD-1X2; 1X02
JLED1, JLED2: MICROMATCH-6
JP: STECKER_ISP_6; STECKER_WANNE_6
JP6: PINHD-1X6/90; 1X06/90
JT: PINHD-1X4; 1X04
LD1: red; LED_3MM
LD2: green; LED_3MM
LED3: LED_3X; LED_TOP_PLCC6
LS: red; LED_3MM
Q1: CRYSTALHC49U70; HC49U70
RB1, RB3, RB5: 1k; 0207/10
RB2, RB4, RB6: 10k; 0207/10
RD1, RD6: 150; 0207/10
RD2: 100k; 0207/10
RD3, RD4: ?; 0207/10
RD5, RD7: 1k; 0207/10
RD8, RD9: 10k; 0207/10
RL1B, RL1G, RL2B, RL2G, RL3B, RL3G: 22; 0207/10
RL1I, RL2I: 150; 0207/10
RL1R, RL2R, RL3R: 40,4; 0207/10
RLD1, RLD2: 2k; 0207/10
RLS: 2k; 0207/10
RP: 300; 0207/10

Connections:
+5V: CD3.1, CM1.1, CM2.1, CS2.1, CS3.+, ICD.8 (VCC), ICL1.9 (CD+), ICL2.9 (CD+), ICM.7 (VCC), ICM.20 (AVCC), ICS.2 (OUT), J201.1, J201.3, J201.8, J201.10, J202.1, J202.3, J202.8, J202.10, J301.1, J301.3, J303.1, J303.3, J502.1, JLED1.1, JLED1.3, JLED1.5, JLED2.1, JLED2.3, JLED2.5, JP.2 (2_VCC), JP6.5, LD1.A, LED3.1 (A), LED3.3 (A), LED3.4 (A), LS.A, RB2.2, RB4.2, RB6.2, RD3.1, RD5.2
BTN1: CB1.1, ICM.14 (PB0(ICP)), RB1.2, RB2.1
BTN2: CB2.1, ICM.26 (PC3(ADC3)), JP6.1, RB3.2, RB4.1
BTNMODE: CB3.1, ICM.6 (PD4(XCK/T0)), RB5.2, RB6.1
BUS_A: DD1.A, ICD.6 (A), J201.5, J202.5, JD1.2, RD6.2
BUS_B: DD2.A, ICD.7 (B), J201.6, J202.6, JD2.2, RD7.2
BUS_DETECT1: CD1.1, ICM.12 (PD6(AIN0)), JD4.2, RD1.2, RD2.2
BUS_DETECT2: CD2.1, ICM.13 (PD7(AIN1)), RD3.2, RD4.2
BUS_ENABLE: ICD.3 (DE), ICM.4 (PD2(INT0)), RD9.1, RLD2.1
BUS_RX: ICD.1 (R), ICM.2 (PD0(RXD)), RLD1.2
BUS_TX: ICD.4 (D), ICM.3 (PD1(TXD))
GND: B1.3, B1.4 (P1), B2.3, B2.4 (P1), BMODE.3, BMODE.4 (P1), CB1.2, CB2.2, CB3.2, CD1.2, CD2.2, CD3.2, CM1.2, CM2.2, CM3.1, CQ1.1, CQ2.1, CS1.2, CS2.2, CS3.-, ICD.5 (GND), ICL1.8 (GND), ICL2.8 (GND), ICM.8 (GND), ICM.22 (GND), ICS.1 (ADJ), J201.2, J201.4, J201.7, J201.9, J202.2, J202.4, J202.7, J202.9, J302.2, J304.2, J305.2, J501.2, J502.2, JD3.2, JP.6 (6_GND), JP6.6, LD2.K (C), RD2.1, RD4.1, RD8.2, RD9.2, RLS.1
IRLED1: ICL1.7 (I7), ICM.5 (PD3(INT1))
IRLED1_OUT: ICL1.10 (O7), RL1I.1
IRLED2_MOSI: ICL2.7 (I7), ICM.17 (PB3(MOSI/OC2)), RP.2
IRLED2_OUT: ICL2.10 (O7), RL2I.1
LED1_B: ICL1.5 (I5), ICL1.6 (I6), ICM.11 (PD5(T1))
LED1_B_OUT: ICL1.11 (O6), ICL1.12 (O5), RL1B.1, RL3B.1
LED1_G: ICL1.3 (I3), ICL1.4 (I4), ICM.16 (PB2(SS/OC1B))
LED1_G_OUT: ICL1.13 (O4), ICL1.14 (O3), RL1G.1, RL3G.1
LED1_R: ICL1.1 (I1), ICL1.2 (I2), ICM.15 (PB1(OC1A))
LED1_R_OUT: ICL1.15 (O2), ICL1.16 (O1), RL1R.1, RL3R.1
LED2_B: ICL2.5 (I5), ICL2.6 (I6), ICM.25 (PC2(ADC2)), JP6.2
LED2_B_OUT: ICL2.11 (O6), ICL2.12 (O5), RL2B.1
LED2_G: ICL2.3 (I3), ICL2.4 (I4), ICM.24 (PC1(ADC1)), JP6.3
LED2_G_OUT: ICL2.13 (O4), ICL2.14 (O3), RL2G.1
LED2_R: ICL2.1 (I1), ICL2.2 (I2), ICM.23 (PC0(ADC0)), JD4.1, JP6.4
LED2_R_OUT: ICL2.15 (O2), ICL2.16 (O1), RL2R.1
unnamed: B1.1 (S), B1.2 (S1), J302.1, RB1.1
unnamed: CS1.1, DS1.C, ICS.3 (IN)
unnamed: B2.1 (S), B2.2 (S1), J304.1, RB3.1
unnamed: BMODE.1 (S), BMODE.2 (S1), J305.1, RB5.1
unnamed: CQ1.2, ICM.10 (PB7(XTAL2/TOSC2)), Q1.1
unnamed: CQ2.2, ICM.9 (PB6(XTAL1/TOSC1)), Q1.2
unnamed: LS.K (C), RLS.2
unnamed: CM3.2, ICM.21 (AREF)
unnamed: JLED1.2, RL1R.2
unnamed: JLED1.4, RL1G.2
unnamed: JLED1.6, RL1B.2
unnamed: JLED2.2, RL2R.2
unnamed: JLED2.4, RL2G.2
unnamed: JLED2.6, RL2B.2
unnamed: J303.2, RL2I.2
unnamed: J301.2, RL1I.2
unnamed: LED3.6 (C), RL3R.2
unnamed: LED3.2 (C), RL3G.2
unnamed: LED3.5 (C), RL3B.2
unnamed: JD1.1, RD5.1
unnamed: ICD.2 (!RE), RD8.1
unnamed: JD2.1, RD6.1
unnamed: LD1.K (C), RLD1.1
unnamed: JD3.1, RD7.1
unnamed: DD1.C, DD2.C, RD1.1
unnamed: LD2.A, RLD2.2
PROG_MISO: ICM.18 (PB4(MISO)), JP.1 (1_MISO)
PROG_MOSI_1: JP.4 (4_MOSI), RP.1
PROG_SCK: ICM.19 (PB5(SCK)), JP.3 (3_SCK)
RESET: ICM.1 (PC6(/RESET)), JP.5 (5_RST)
TWI_SCL: ICM.28 (PC5(ADC5/SCL)), JT.1, JT.4
TWI_SDA: ICM.27 (PC4(ADC4/SDA)), JT.2, JT.3
V+: DS1.A, J501.1

Notes on the sheet:
Peter Weissig
Supply
Buttons
MCU
Note: Using atmega8 schematics. Pin-layout is the same.
LED-Driver
LED
Reserve
GND
Vcc
(Store)
Data 1
Data 2
Data 3
Data 4
(Shift)
(!OE)
(DS)
Programmer
BUS-Driver
Note: SN75176 & ADM485 share the same layout.
Note: Value of RD3 and RD4 depend on ICD! SN75176: RD3= ; RD4= ADM485: RD3= ; RD4=
Note: Possible extended Bus-Detection through ADC-Pin 0. E.g. Idle-Detection. Only if in single-light-mode (not 2 lights). ==> Therefore using a jumper

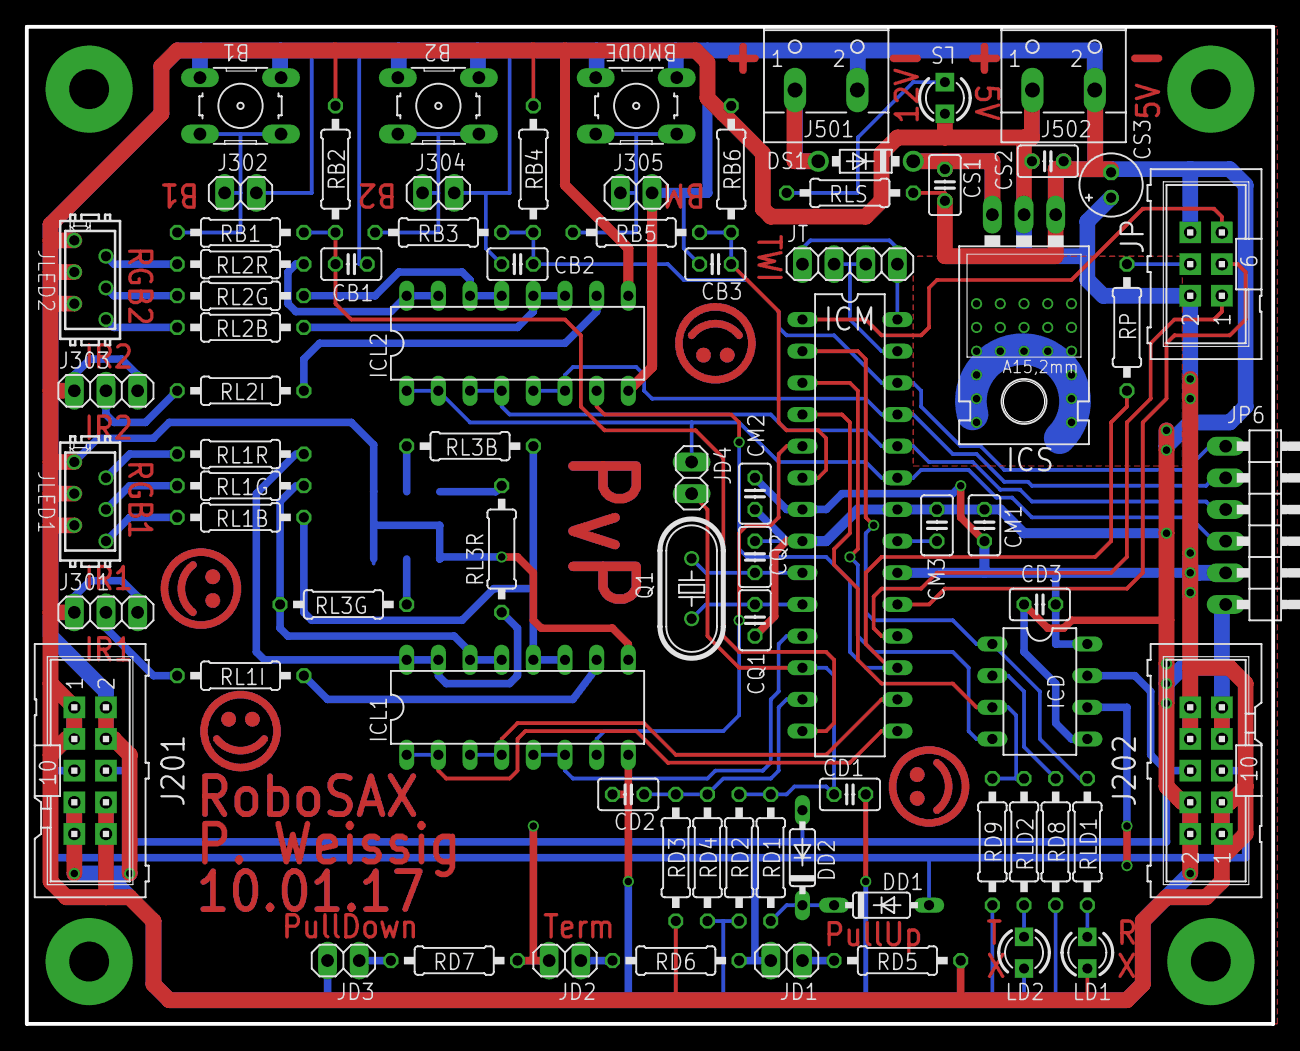
[picture p9: board circuit.brd from above]

Board: 2 copper layers, 100.0 x 80.0 mm, 78 parts (1 on the bottom side), 61 nets.
