RoboSAX/eagle_licht/(commit log)

2018-01-08 initial commit + added simple circuit (no layout yet)
    [circuit.sch]
2018-01-08 updated circuit + added layout (not done yet)
    [circuit.brd, circuit.sch]
2018-01-10 updated circuit + layout is done + updated export files
    [circuit.brd, circuit.sch]
2018-01-10 finished layout and exported data
    [circuit.GBL, circuit.GBO, circuit.GBP, circuit.GBS, circuit.GTL, circuit.GTO, circuit.GTP, circuit.GTS]
2018-01-11 added part-list and approximate pricing
    [parts.ods]
2018-01-13 bugfixed partlist (changed some numbers; added 300R)
    [parts.ods]
2018-01-22 monir bugfixes + ULN2003 has socket of 2x8 not 2x7 (updated part-list) + switched label of resistors (RD8 and RLD1) + updated LED3 (removed solder resist) + moved 2 labels, so that they will be visib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
    [circuit.brd, circuit.sch, parts.ods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]
2018-01-29 updated circuit (added simplified version & minor bugfixes)
    [circuit.GBL, circuit.GBO, circuit.GBP, circuit.GBS, circuit.GTL, circuit.GTO, circuit.GTP, circuit.GTS]
2018-02-11 switched color of LD1 and LD2 in full version
    [circuit.brd, circuit.sch, parts.ods]
